mae223-oceantech/rtk-wave-buoy-firmware-team-2-neptune-protocol/Deliverables/ACCELEROMETER_PERFORMANCE/imuLog00029.csv

Timestamp | Sensor | AccX | AccY | AccZ | GyrX | GyrY | GyrZ | MagX | MagY | MagZ | Temp
2026/04/13 14:56:30.00 | IMU | -38.09 | -4.88 | -1002.93 | -1.14 | -0.45 | 0.96 | -10.35 | 10.95 | -31.95 | 27.8
2026/04/13 14:56:30.10 | IMU | -31.74 | -18.55 | -1005.86 | -3.49 | -0.89 | 1.06 | -9.75 | 11.55 | -32.55 | 27.9
2026/04/13 14:56:30.20 | IMU | -45.41 | -19.53 | -991.21 | -2.39 | -2.35 | -0.75 | -9.60 | 10.95 | -31.20 | 28.0
2026/04/13 14:56:30.30 | IMU | -42.48 | -6.35 | -996.58 | -0.85 | -2.53 | -2.27 | -11.10 | 10.20 | -31.65 | 28.2
2026/04/13 14:56:30.40 | IMU | -41.99 | -18.07 | -1008.30 | -1.37 | 0.21 | 0.05 | -11.40 | 10.20 | -31.95 | 28.0
2026/04/13 14:56:30.50 | IMU | -44.92 | -12.21 | -1003.91 | -0.94 | -3.08 | -1.38 | -10.05 | 10.50 | -32.10 | 28.2
2026/04/13 14:56:30.60 | IMU | -38.57 | -9.28 | -994.63 | -1.49 | -0.56 | -0.44 | -10.05 | 10.80 | -31.80 | 28.2
2026/04/13 14:56:30.70 | IMU | -48.83 | -18.07 | -993.16 | -0.43 | -1.53 | -0.62 | -10.80 | 10.50 | -33.30 | 27.9
2026/04/13 14:56:30.80 | IMU | -28.81 | -23.44 | -1008.79 | -2.18 | 0.08 | 0.98 | -10.65 | 11.85 | -31.95 | 28.0
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
