mae223-oceantech/rtk-wave-buoy-firmware-team-2-neptune-protocol/Deliverables/ACCELEROMETER_PERFORMANCE/imuLog00034.csv

Timestamp | Sensor | AccX | AccY | AccZ | GyrX | GyrY | GyrZ | MagX | MagY | MagZ | Temp
2026/04/13 14:56:30.00 | IMU | 68.36 | -13.18 | 1007.81 | -2.44 | -0.43 | -4.02 | 18.60 | 9.45 | 61.95 | 29.9
2026/04/13 14:56:30.10 | IMU | 51.76 | -17.09 | 1227.05 | 1.00 | -7.21 | 0.52 | 18.30 | 7.95 | 61.65 | 30.0
2026/04/13 14:56:30.20 | IMU | 21.48 | -17.58 | 1016.60 | -0.42 | -0.94 | -0.08 | 19.50 | 8.10 | 63.60 | 29.9
2026/04/13 14:56:30.30 | IMU | 48.83 | -20.02 | 981.45 | 0.30 | 0.60 | -0.59 | 19.20 | 8.10 | 63.60 | 29.9
2026/04/13 14:56:30.40 | IMU | 43.46 | -15.14 | 995.12 | 0.46 | 2.54 | -2.41 | 17.70 | 7.65 | 62.55 | 29.8
2026/04/13 14:56:30.50 | IMU | 55.66 | -11.72 | 1005.37 | -0.56 | 1.37 | -1.99 | 19.80 | 9.00 | 62.25 | 29.9
2026/04/13 14:56:30.60 | IMU | 17.58 | -21.48 | 993.16 | -1.18 | 0.18 | 0.08 | 20.10 | 8.25 | 62.25 | 30.0
2026/04/13 14:56:30.70 | IMU | 35.64 | -17.09 | 980.47 | -3.97 | -2.25 | 0.47 | 19.35 | 8.70 | 61.20 | 29.8
2026/04/13 14:56:30.80 | IMU | 13.18 | -7.81 | 985.35 | -1.66 | 1.40 | -1.05 | 20.55 | 9.00 | 61.95 | 29.8
2026/04/13 14:56:30.90 | IMU | 40.53 | -3.42 | 1014.16 | -0.37 | 1.72 | -1.63 | 17.70 | 8.10 | 60.30 | 29.9
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
