mae223-oceantech/rtk-wave-buoy-firmware-team-2-neptune-protocol/Deliverables/ACCELEROMETER_PERFORMANCE/imuLog00040.csv

Timestamp | Sensor | AccX | AccY | AccZ | GyrX | GyrY | GyrZ | MagX | MagY | MagZ | Temp
2026/04/13 14:56:30.00 | IMU | -11.72 | -4.88 | -1010.25 | -1.57 | -1.22 | -1.11 | -27.90 | -11.25 | -70.35 | 29.1
2026/04/13 14:56:30.10 | IMU | -23.44 | -42.97 | -988.28 | 0.07 | -4.27 | -0.61 | -25.80 | -10.95 | -70.50 | 28.9
2026/04/13 14:56:30.20 | IMU | -4.88 | -4.39 | -1020.02 | -3.19 | 0.82 | -2.73 | -26.85 | -10.65 | -70.80 | 28.7
2026/04/13 14:56:30.30 | IMU | -19.04 | -8.79 | -1017.09 | -0.44 | 0.79 | -0.16 | -27.45 | -11.25 | -69.90 | 28.8
2026/04/13 14:56:30.40 | IMU | -5.86 | -21.00 | -995.61 | -1.83 | -0.69 | 0.21 | -26.10 | -12.60 | -70.80 | 28.9
2026/04/13 14:56:30.50 | IMU | -21.00 | -8.79 | -1002.93 | -1.30 | -1.94 | -0.21 | -26.85 | -11.40 | -70.80 | 29.0
2026/04/13 14:56:30.60 | IMU | -13.18 | -17.09 | -1002.44 | -0.14 | -0.48 | 0.05 | -26.70 | -9.60 | -68.40 | 29.1
2026/04/13 14:56:30.70 | IMU | -14.16 | -18.07 | -1004.88 | -1.73 | -1.79 | -2.54 | -27.30 | -10.20 | -69.75 | 29.0
2026/04/13 14:56:30.80 | IMU | -5.37 | -29.30 | -1019.53 | -0.76 | 0.06 | 1.99 | -27.45 | -11.55 | -70.65 | 29.1
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
