mae223-oceantech/rtk-wave-buoy-firmware-team-2-neptune-protocol/Deliverables/ACCELEROMETER_PERFORMANCE/imuLog00044.csv

Timestamp | Sensor | AccX | AccY | AccZ | GyrX | GyrY | GyrZ | MagX | MagY | MagZ | Temp
2026/04/13 14:56:30.00 | IMU | -14.16 | -24.41 | -1008.79 | -0.45 | -2.40 | 2.33 | 7.05 | 26.70 | -37.35 | 29.6
2026/04/13 14:56:30.10 | IMU | -16.11 | -29.79 | -1004.39 | -1.05 | 0.99 | -1.59 | 8.55 | 26.70 | -38.40 | 29.6
2026/04/13 14:56:30.20 | IMU | -18.55 | -31.74 | -1012.70 | -4.47 | -0.77 | -3.64 | 8.55 | 25.65 | -36.15 | 29.6
2026/04/13 14:56:30.30 | IMU | -17.58 | -19.53 | -1016.11 | -1.44 | 0.23 | 1.77 | 8.85 | 26.25 | -36.45 | 29.7
2026/04/13 14:56:30.40 | IMU | -21.48 | -23.93 | -992.19 | -0.15 | 0.05 | -1.63 | 6.75 | 24.90 | -36.60 | 29.3
2026/04/13 14:56:30.50 | IMU | -17.58 | -31.74 | -1011.72 | -1.63 | 0.27 | 0.94 | 8.55 | 26.55 | -37.50 | 29.6
2026/04/13 14:56:30.60 | IMU | -20.02 | -28.81 | -1013.18 | -0.89 | -1.56 | -2.83 | 7.35 | 25.05 | -37.20 | 29.6
2026/04/13 14:56:30.70 | IMU | -13.67 | -35.64 | -993.65 | -2.06 | -2.37 | -3.94 | 8.25 | 25.95 | -37.65 | 29.8
2026/04/13 14:56:30.80 | IMU | -19.53 | -30.27 | -1016.60 | -2.21 | -1.40 | 0.96 | 7.35 | 25.35 | -36.75 | 29.6
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
