mae223-oceantech/rtk-wave-buoy-firmware-team-2-neptune-protocol/Deliverables/ACCELEROMETER_PERFORMANCE/imuLog00048.csv

Timestamp | Sensor | AccX | AccY | AccZ | GyrX | GyrY | GyrZ | MagX | MagY | MagZ | Temp
2026/04/13 14:56:30.00 | IMU | -5.86 | -964.84 | -273.44 | -2.82 | -2.51 | -4.25 | 11.10 | -34.35 | -21.90 | 27.5
2026/04/13 14:56:30.10 | IMU | 7.81 | -1017.58 | -279.79 | -3.06 | -3.68 | 1.36 | 10.65 | -35.10 | -21.15 | 27.8
2026/04/13 14:56:30.20 | IMU | -16.60 | -983.89 | -271.97 | 0.02 | 1.11 | -2.57 | 10.50 | -33.45 | -21.45 | 27.6
2026/04/13 14:56:30.30 | IMU | -3.91 | -1000.49 | -296.39 | -0.35 | -0.63 | -1.66 | 12.00 | -33.75 | -21.45 | 27.8
2026/04/13 14:56:30.40 | IMU | -12.21 | -978.52 | -285.64 | -1.50 | -1.94 | -1.50 | 12.60 | -33.60 | -20.85 | 27.6
2026/04/13 14:56:30.50 | IMU | -4.88 | -974.61 | -260.25 | -1.58 | -0.57 | -1.11 | 11.10 | -34.35 | -21.60 | 27.8
2026/04/13 14:56:30.60 | IMU | -45.90 | -968.26 | -328.61 | 0.53 | -8.92 | -0.73 | 11.85 | -35.55 | -22.35 | 27.9
2026/04/13 14:56:30.70 | IMU | 6.84 | -989.75 | -245.12 | 3.97 | -4.22 | -10.03 | 11.85 | -34.35 | -20.10 | 27.9
2026/04/13 14:56:30.80 | IMU | -14.65 | -969.73 | -239.26 | -1.69 | 0.56 | -0.36 | 10.35 | -35.10 | -20.55 | 27.8
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
