mae223-oceantech/rtk-wave-buoy-firmware-team-2-neptune-protocol/Deliverables/ACCELEROMETER_PERFORMANCE/a1_timeseries.png

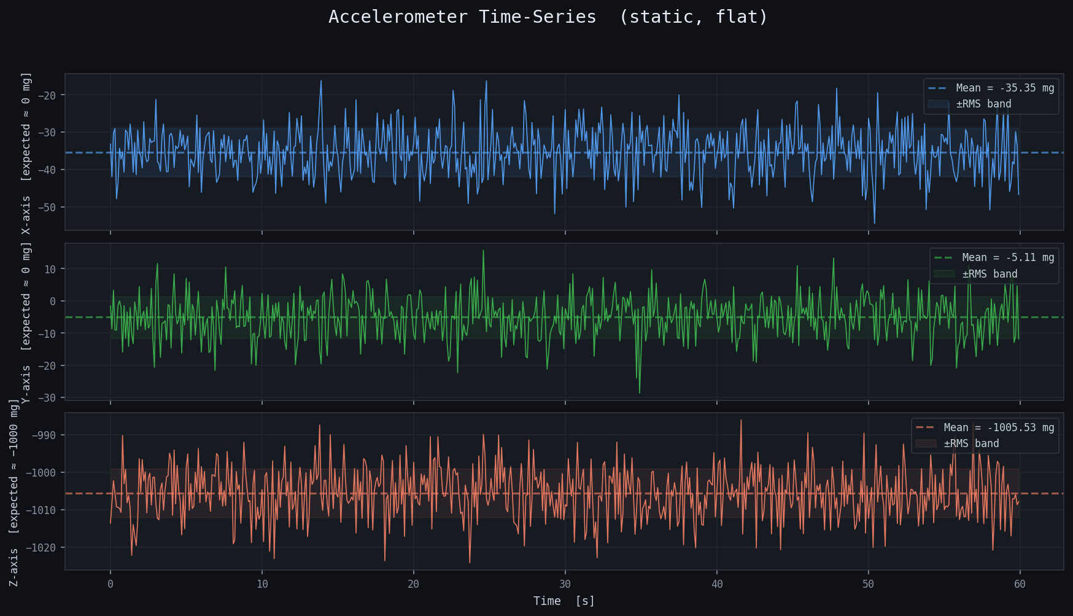
Deliverables/ACCELEROMETER_PERFORMANCE/a1_timeseries.png
