mae223-oceantech/rtk-wave-buoy-firmware-team-2-neptune-protocol/Deliverables/ACCELEROMETER_PERFORMANCE/a2_noise_histogram.png

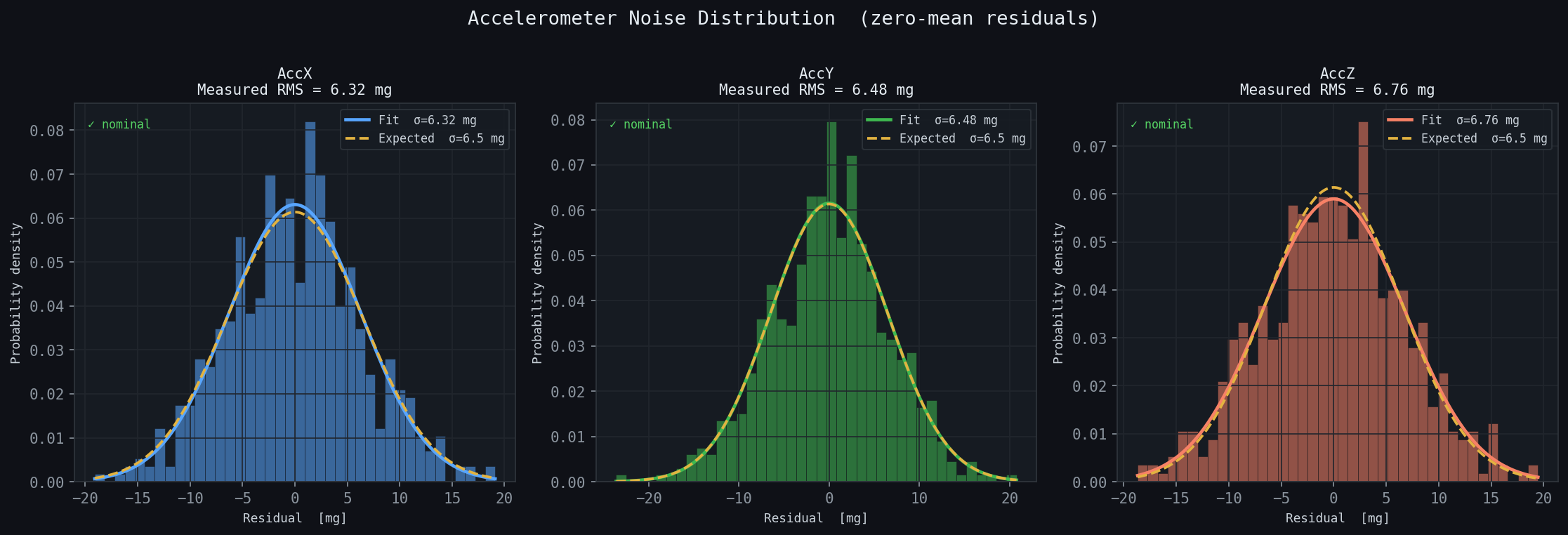
Deliverables/ACCELEROMETER_PERFORMANCE/a2_noise_histogram.png
