mae223-oceantech/rtk-wave-buoy-firmware-team-2-neptune-protocol/Deliverables/ACCELEROMETER_PERFORMANCE/a3_sixface_calibration.png

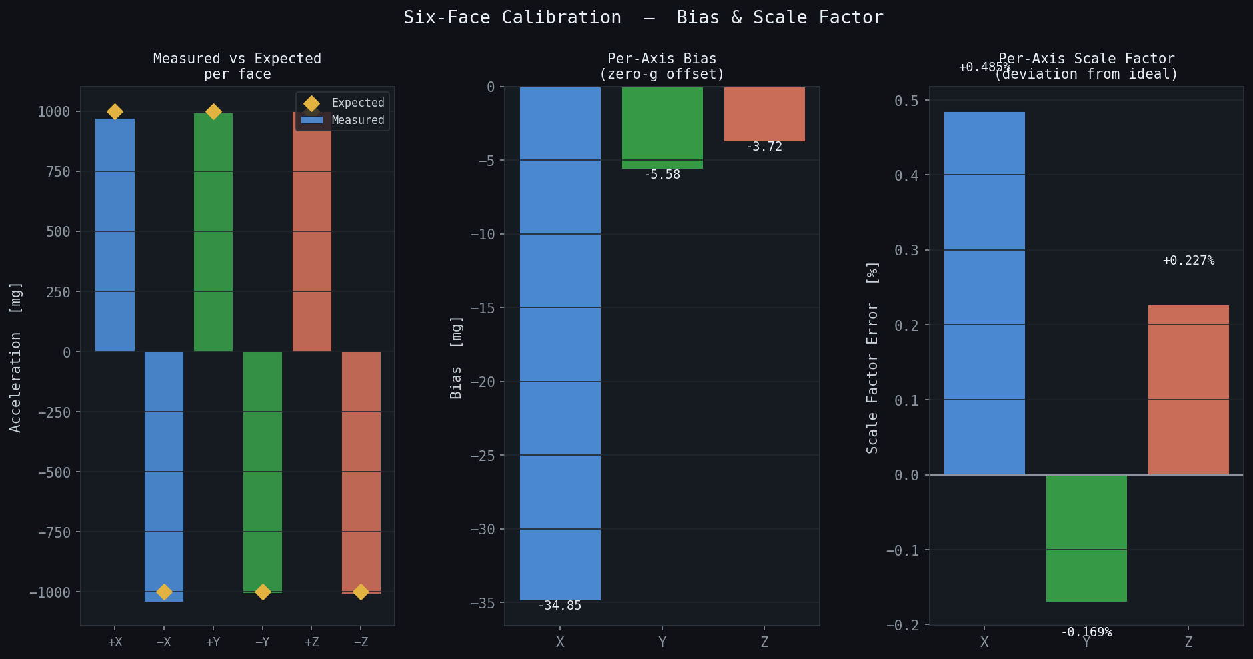
Deliverables/ACCELEROMETER_PERFORMANCE/a3_sixface_calibration.png
