mae223-oceantech/rtk-wave-buoy-firmware-team-2-neptune-protocol/Deliverables/ACCELEROMETER_PERFORMANCE/a4_gravity_magnitude.png

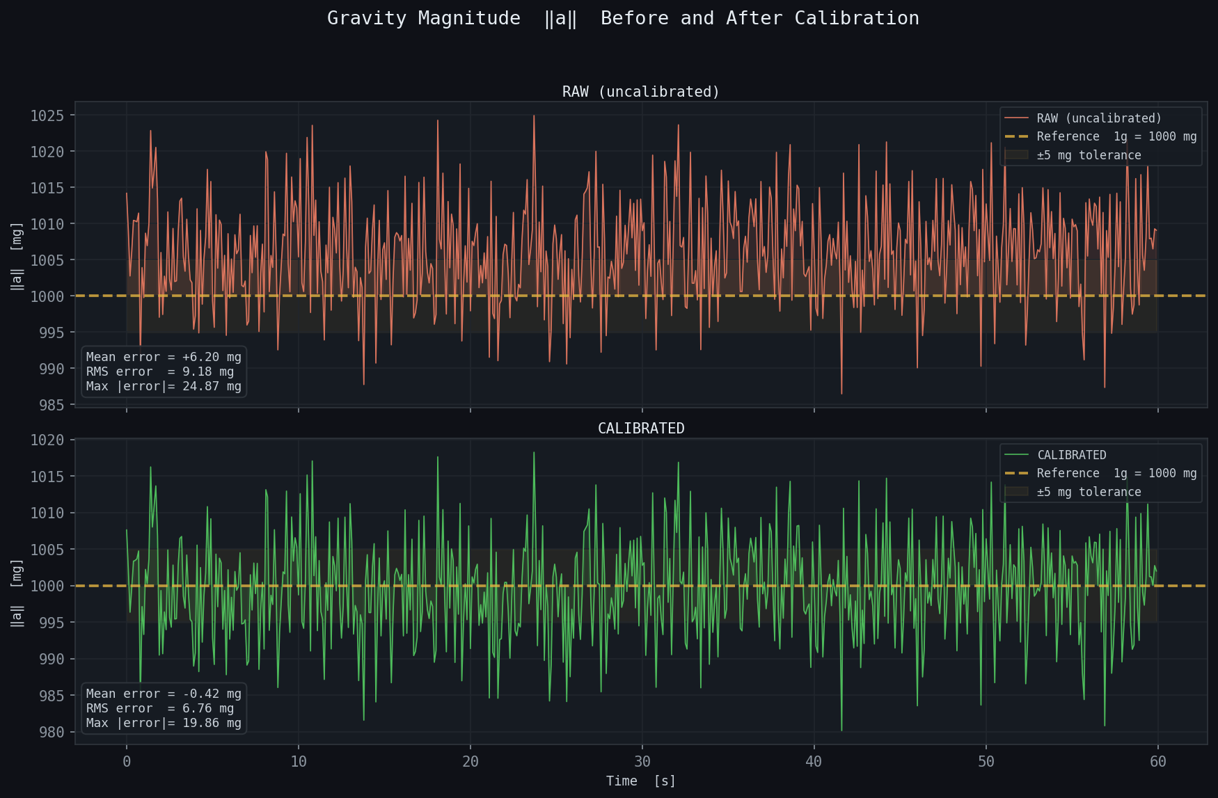
Deliverables/ACCELEROMETER_PERFORMANCE/a4_gravity_magnitude.png
