mae223-oceantech/rtk-wave-buoy-firmware-team-2-neptune-protocol/(commit log)

2026-03-17 Add esp32_rtk_wifi.ino - WiFi NTRIP client with BLE command interface
    - UART connection to ZED-F9P using SparkFun GNSS library (read + write)
    - BLE Nordic UART Service for wireless monitoring and configuration
    - Unique BLE device name using last 2 bytes of MAC address (RTK-Buoy-XXXX)
    - Commands: STATUS, GPS, RESET, SLEEP, GET, SET
    - NTRIP config (host, port, mount, user, pass) persists to NVS flash
    - Periodic GPS broadcast over BLE every 5 seconds
    - buoyPrint/buoyPrintln helper mirrors output to Serial and BLE
    [esp32_rtk_wifi.ino]
2026-03-17 Add partition scheme note to README
    WiFi + BLE exceeds default 1.28MB partition; document the
    No OTA (Large APP) setting required to compile esp32_rtk_wifi.
2026-04-06 Fix IMU float formatting and enable IMU-only logging without GPS
    Apollo3 snprintf doesn't support %f (outputs literal format specifiers).
    Added floatToStr() helper for manual float-to-string conversion.
    Also added independent IMU file sync path so data flushes to SD
    when GNSS module is not connected.
    [OpenLog_Artemis_GNSS_Logging.ino]
2026-04-06 Add IMU student guide for standalone data logger exercise
    Step-by-step instructions for students to record and plot IMU data
    using the OpenLog Artemis without GPS hardware.
2026-04-13 Consolidate guides into tutorials/ folder, rename documents/
    - Moved all markdown guides from accelerometer/ and documents/ into tutorials/
    - Updated README folder structure to reflect new layout
2026-04-20 Accelerometer performance
    [imuLog00029.csv, imuLog00034.csv, imuLog00040.csv, imuLog00044.csv, imuLog00048.csv, imuLog_flat.csv]
